MagicSmokeFireworks/magic-smoke-board/README.md

# magic-smoke-board
Electronics schematics, layouts, and part info for the awesome Magic Smoke board.
