MagicSmokeFireworks/magic-smoke-board/cute_octopus_by_jedec.png

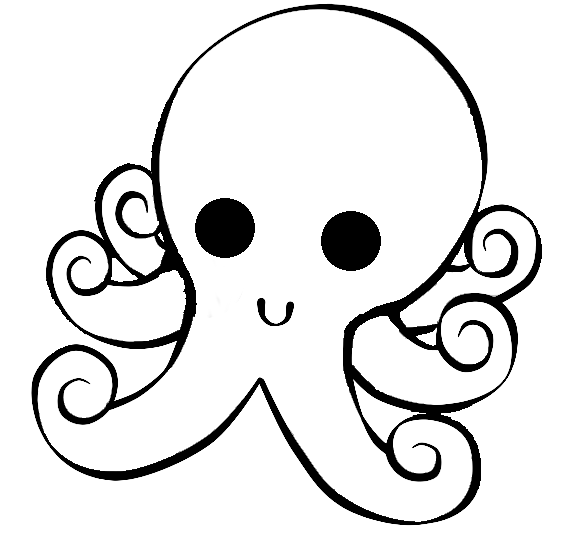
cute_octopus_by_jedec.png
