MagicSmokeFireworks/magic-smoke-board/remote-pallet.kicad_pcb

## KiCad design remote-pallet.kicad_pcb (2019-06-02)

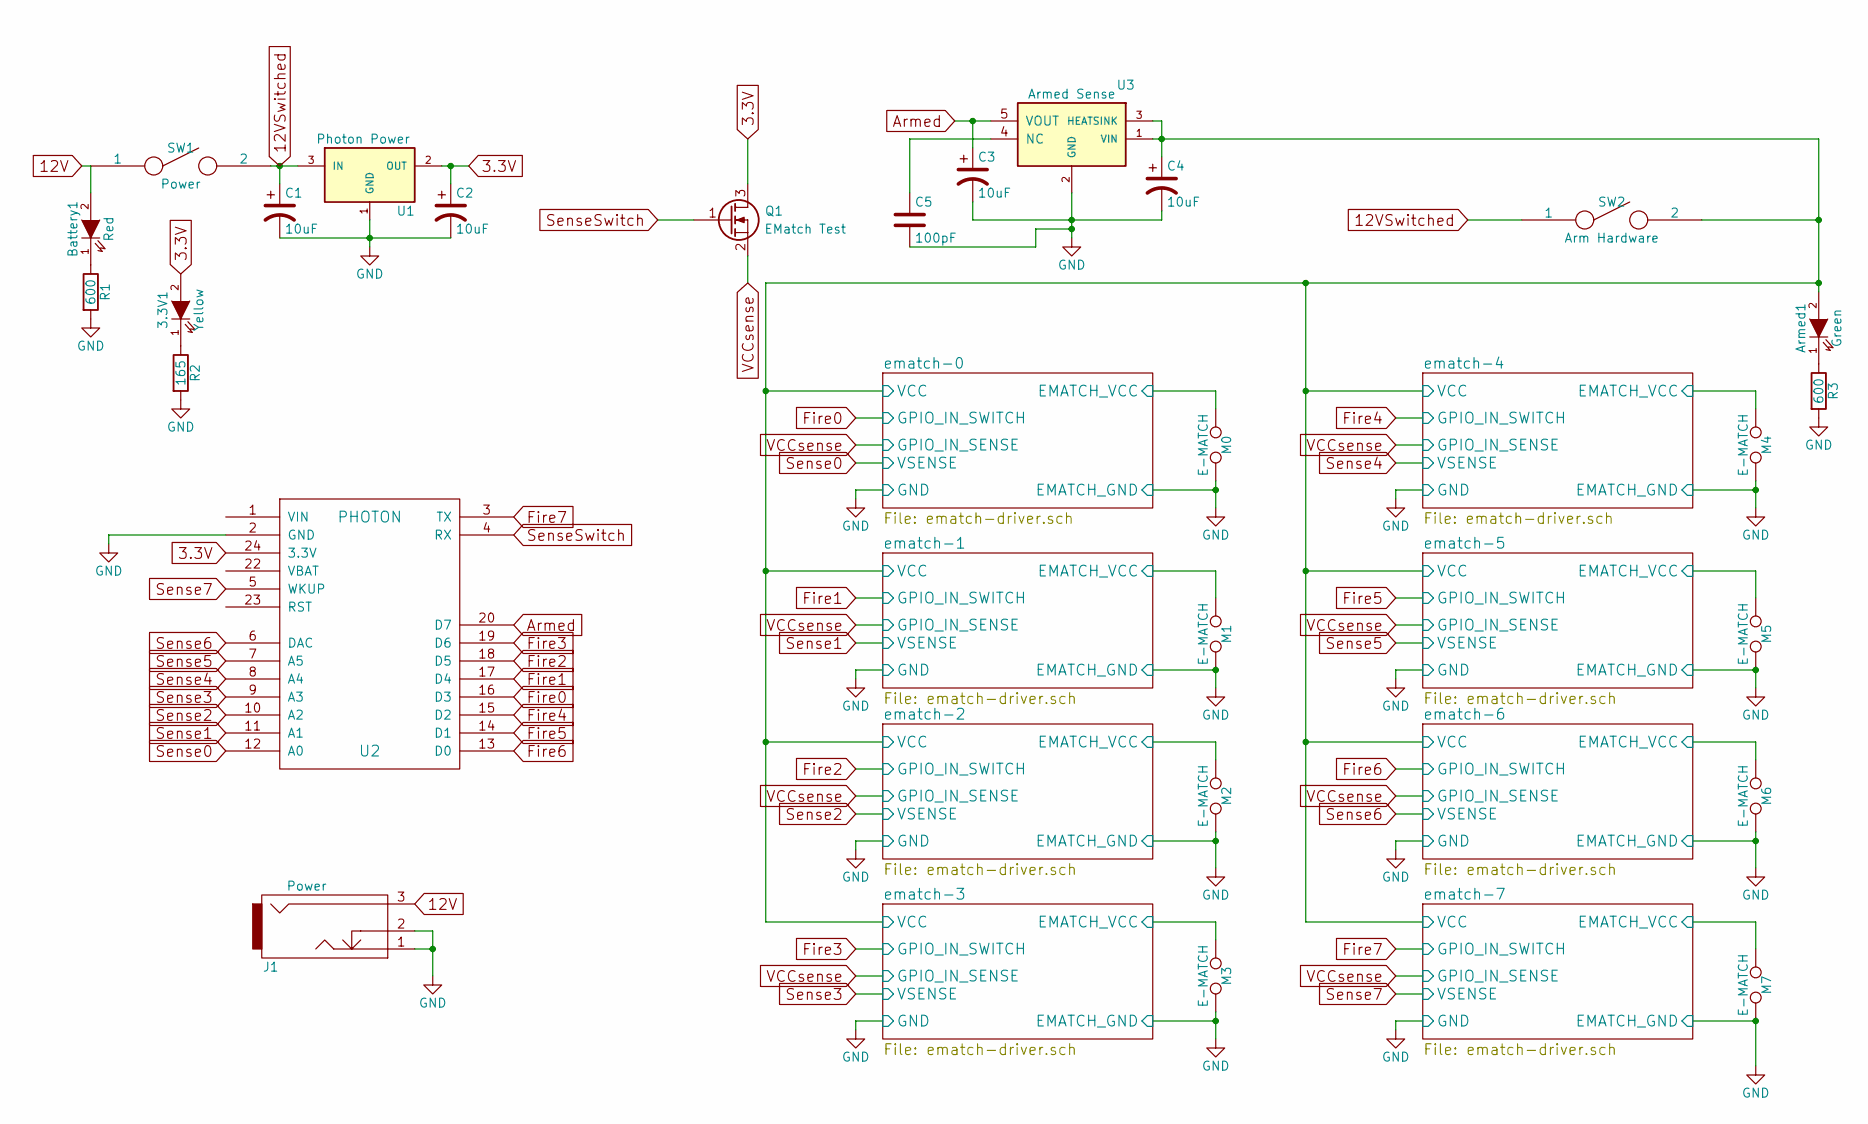
[picture p2: schematic remote-pallet.sch, Fireworks Remote Pallet]

Parts:
3.3V1: Yellow; LED_0603; digikey part no 732-4981-1-ND
Armed1: Green; LED_0603; digikey part no 732-4971-1-ND
Battery1: Red; LED_0603; digikey part no 732-4978-1-ND
C1, C2: 10uF; C_0805_HandSoldering; digikey part no 511-1683-1-ND
C3: 10uF; C_0805_HandSoldering; digikey part no 587-1290-1-ND
C4: 10uF; C_0805_HandSoldering; digikey part no 490-5523-1-ND
C5: 100pF; C_0805_HandSoldering
J1: Power; PJ-082BH-Barrel-Connector; digikey part no CP-082BHCT-ND
M0, M1, M2, M3, M4, M5, M6, M7: E-MATCH; TerminalBlock_Altech_AK300-2_P5.00mm; digikey part no 277-2518-ND
Q1: EMatch Test; SOT-23_Handsoldering; digikey part no SSM3K324RLFCT-ND
R1, R3: 600; R_0603_HandSoldering; digikey part no 311-600HCT-ND
R2: 165; R_0603_HandSoldering; digikey part no 311-165HRCT-ND
SW1: Power; M2011LL1W01; digikey part no 360-3287-ND
SW2: Arm Hardware; M2011LL1W01; digikey part no 360-3287-ND
U1: Photon Power; TO-263-3Lead; digikey part no LM1085ISX-3.3/NOPBCT-ND
U2: PHOTON
U3: Armed Sense; SOT-23-5; digikey part no AP2202K-3.3TRG1DICT-ND

Connections:
3.3V: 3.3V1.2 (A), C2.1, Q1.3 (D), U1.2 (OUT), U2.24 (3.3V)
12V: Battery1.2 (A), J1.3, SW1.1
12VSwitched: C1.1, SW1.2, SW2.1, U1.3 (IN)
/ematch-0/EMATCH_VCC: M0.1; also elsewhere on the board
/ematch-0/VCC: Armed1.2 (A), C4.1, SW2.2, U3.1 (VIN), U3.3 (HEATSINK); also elsewhere on the board
/ematch-1/EMATCH_VCC: M1.1; also elsewhere on the board
/ematch-2/EMATCH_VCC: M2.1; also elsewhere on the board
/ematch-3/EMATCH_VCC: M3.1; also elsewhere on the board
/ematch-4/EMATCH_VCC: M4.1; also elsewhere on the board
/ematch-5/EMATCH_VCC: M5.1; also elsewhere on the board
/ematch-6/EMATCH_VCC: M6.1; also elsewhere on the board
/ematch-7/EMATCH_VCC: M7.1; also elsewhere on the board
Armed: C3.1, U2.20 (D7), U3.5 (VOUT)
Fire0: U2.16 (D3); also elsewhere on the board
Fire1: U2.17 (D4); also elsewhere on the board
Fire2: U2.18 (D5); also elsewhere on the board
Fire3: U2.19 (D6); also elsewhere on the board
Fire4: U2.15 (D2); also elsewhere on the board
Fire5: U2.14 (D1); also elsewhere on the board
Fire6: U2.13 (D0); also elsewhere on the board
Fire7: U2.3 (TX); also elsewhere on the board
GND: C1.2, C2.2, C3.2, C4.2, C5.2, J1.1, J1.2, M0.2, M1.2, M2.2, M3.2, M4.2, M5.2, M6.2, M7.2, R1.2, R2.2, R3.2, U1.1 (GND), U2.2 (GND), U3.2 (GND); also elsewhere on the board
unnamed: 3.3V1.1 (K), R2.1
unnamed: Armed1.1 (K), R3.1
unnamed: Battery1.1 (K), R1.1
unnamed: C5.1, U3.4 (NC)
Sense0: U2.12 (A0); also elsewhere on the board
Sense1: U2.11 (A1); also elsewhere on the board
Sense2: U2.10 (A2); also elsewhere on the board
Sense3: U2.9 (A3); also elsewhere on the board
Sense4: U2.8 (A4); also elsewhere on the board
Sense5: U2.7 (A5); also elsewhere on the board
Sense6: U2.6 (DAC); also elsewhere on the board
Sense7: U2.5 (WKUP); also elsewhere on the board
SenseSwitch: Q1.1 (G), U2.4 (RX)
VCCsense: Q1.2 (S); also elsewhere on the board

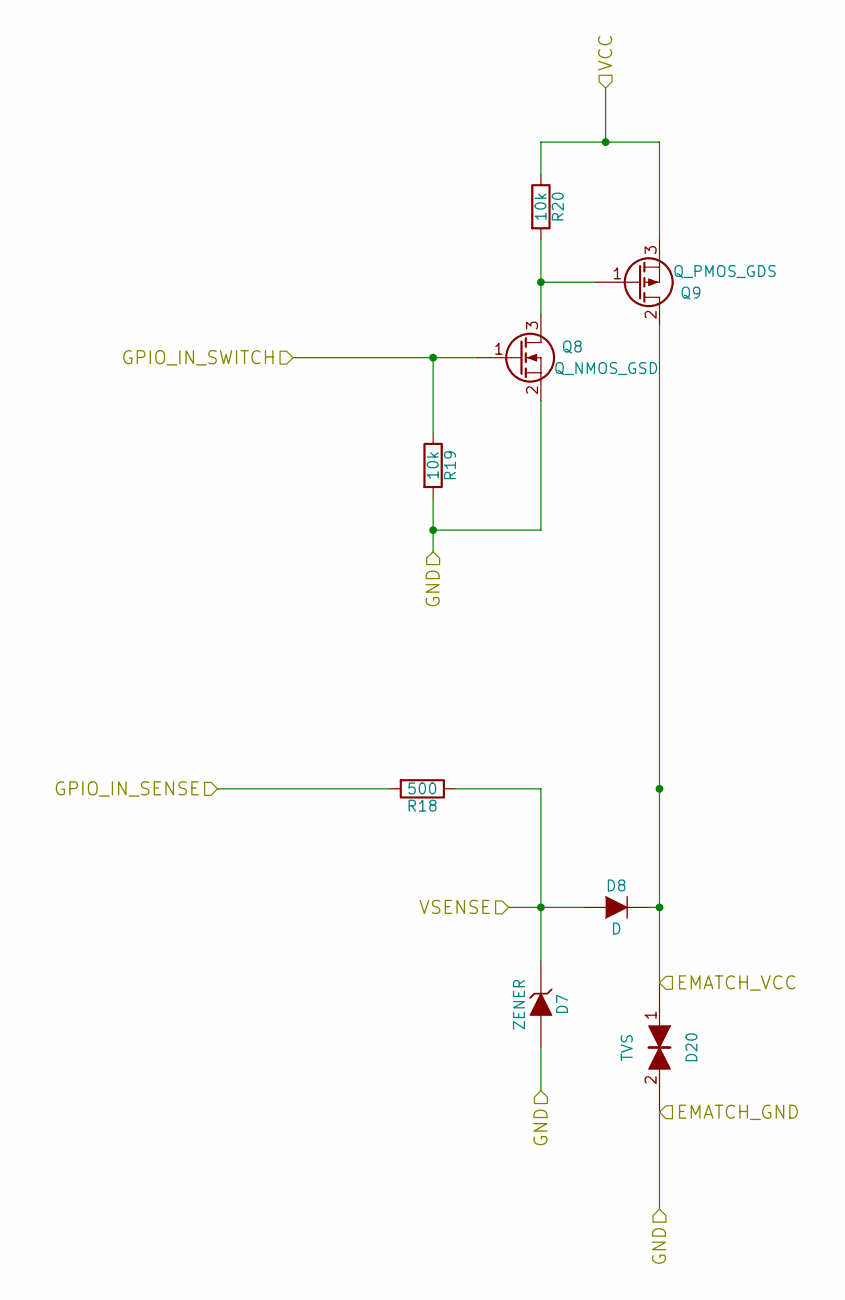
[picture p3: schematic ematch-driver.sch]

Parts:
D1: ZENER; SOD-123; digikey part no CD0603-Z3V3CT-ND
D2: D; SOD-123; digikey part no 641-1282-2-ND
D17: TVS; D_SMA_Handsoldering; digikey part no SMAJ30CALFTR-ND
Q2: Q_NMOS_GSD; SOT-23_Handsoldering; digikey part no SSM3K324RLFCT-ND
Q3: Q_PMOS_GDS; TO-252-2Lead; digikey part no NTD2955T4GOSCT-ND
R9: 500; R_0603_HandSoldering; digikey part no 311-499HRCT-ND
R10, R11: 10k; R_0603_HandSoldering; digikey part no 311-10KGRCT-ND

Connections:
/ematch-0/EMATCH_VCC: D2.1 (K), D17.1, Q3.2 (D); also elsewhere on the board
/ematch-0/VCC: Q3.3 (S), R11.1; also elsewhere on the board
Fire0: Q2.1 (G), R10.1; also elsewhere on the board
GND: D1.2 (A), D17.2, Q2.2 (S), R10.2; also elsewhere on the board
unnamed: Q2.3 (D), Q3.1 (G), R11.2
Sense0: D1.1 (K), D2.2 (A), R9.1; also elsewhere on the board
VCCsense: R9.2; also elsewhere on the board

Parts of its further copies:
D3, D5, D7, D9, D11, D13, D15: ZENER; SOD-123; digikey part no CD0603-Z3V3CT-ND
D4, D6, D8, D10, D12, D14, D16: D; SOD-123; digikey part no 641-1282-2-ND
D18, D19, D20, D21, D22, D23, D24: TVS; D_SMA_Handsoldering; digikey part no SMAJ30CALFTR-ND
Q4, Q6, Q8, Q10, Q12, Q14, Q16: Q_NMOS_GSD; SOT-23_Handsoldering; digikey part no SSM3K324RLFCT-ND
Q5, Q7, Q9, Q11, Q13, Q15, Q17: Q_PMOS_GDS; TO-252-2Lead; digikey part no NTD2955T4GOSCT-ND
R12, R15, R18, R21, R24, R27, R30: 500; R_0603_HandSoldering; digikey part no 311-499HRCT-ND
R13, R14, R16, R17, R19, R20, R22, R23, R25, R26, R28, R29, R31, R32: 10k; R_0603_HandSoldering; digikey part no 311-10KGRCT-ND

Connections of its further copies:
/ematch-0/VCC: Q5.3 (S), Q7.3 (S), Q9.3 (S), Q11.3 (S), Q13.3 (S), Q15.3 (S), Q17.3 (S), R14.1, R17.1, R20.1, R23.1, R26.1, R29.1, R32.1; also elsewhere on the board
/ematch-1/EMATCH_VCC: D4.1 (K), D18.1, Q5.2 (D); also elsewhere on the board
/ematch-2/EMATCH_VCC: D6.1 (K), D19.1, Q7.2 (D); also elsewhere on the board
/ematch-3/EMATCH_VCC: D8.1 (K), D20.1, Q9.2 (D); also elsewhere on the board
/ematch-4/EMATCH_VCC: D10.1 (K), D21.1, Q11.2 (D); also elsewhere on the board
/ematch-5/EMATCH_VCC: D12.1 (K), D22.1, Q13.2 (D); also elsewhere on the board
/ematch-6/EMATCH_VCC: D14.1 (K), D23.1, Q15.2 (D); also elsewhere on the board
/ematch-7/EMATCH_VCC: D16.1 (K), D24.1, Q17.2 (D); also elsewhere on the board
Fire1: Q4.1 (G), R13.1; also elsewhere on the board
Fire2: Q6.1 (G), R16.1; also elsewhere on the board
Fire3: Q8.1 (G), R19.1; also elsewhere on the board
Fire4: Q10.1 (G), R22.1; also elsewhere on the board
Fire5: Q12.1 (G), R25.1; also elsewhere on the board
Fire6: Q14.1 (G), R28.1; also elsewhere on the board
Fire7: Q16.1 (G), R31.1; also elsewhere on the board
GND: D3.2 (A), D5.2 (A), D7.2 (A), D9.2 (A), D11.2 (A), D13.2 (A), D15.2 (A), D18.2, D19.2, D20.2, D21.2, D22.2, D23.2, D24.2, Q4.2 (S), Q6.2 (S), Q8.2 (S), Q10.2 (S), Q12.2 (S), Q14.2 (S), Q16.2 (S), R13.2, R16.2, R19.2, R22.2, R25.2, R28.2, R31.2; also elsewhere on the board
unnamed: Q4.3 (D), Q5.1 (G), R14.2
unnamed: Q6.3 (D), Q7.1 (G), R17.2
unnamed: Q8.3 (D), Q9.1 (G), R20.2
unnamed: Q10.3 (D), Q11.1 (G), R23.2
unnamed: Q12.3 (D), Q13.1 (G), R26.2
unnamed: Q14.3 (D), Q15.1 (G), R29.2
unnamed: Q16.3 (D), Q17.1 (G), R32.2
Sense1: D3.1 (K), D4.2 (A), R12.1; also elsewhere on the board
Sense2: D5.1 (K), D6.2 (A), R15.1; also elsewhere on the board
Sense3: D7.1 (K), D8.2 (A), R18.1; also elsewhere on the board
Sense4: D9.1 (K), D10.2 (A), R21.1; also elsewhere on the board
Sense5: D11.1 (K), D12.2 (A), R24.1; also elsewhere on the board
Sense6: D13.1 (K), D14.2 (A), R27.1; also elsewhere on the board
Sense7: D15.1 (K), D16.2 (A), R30.1; also elsewhere on the board
VCCsense: R12.2, R15.2, R18.2, R21.2, R24.2, R27.2, R30.2; also elsewhere on the board

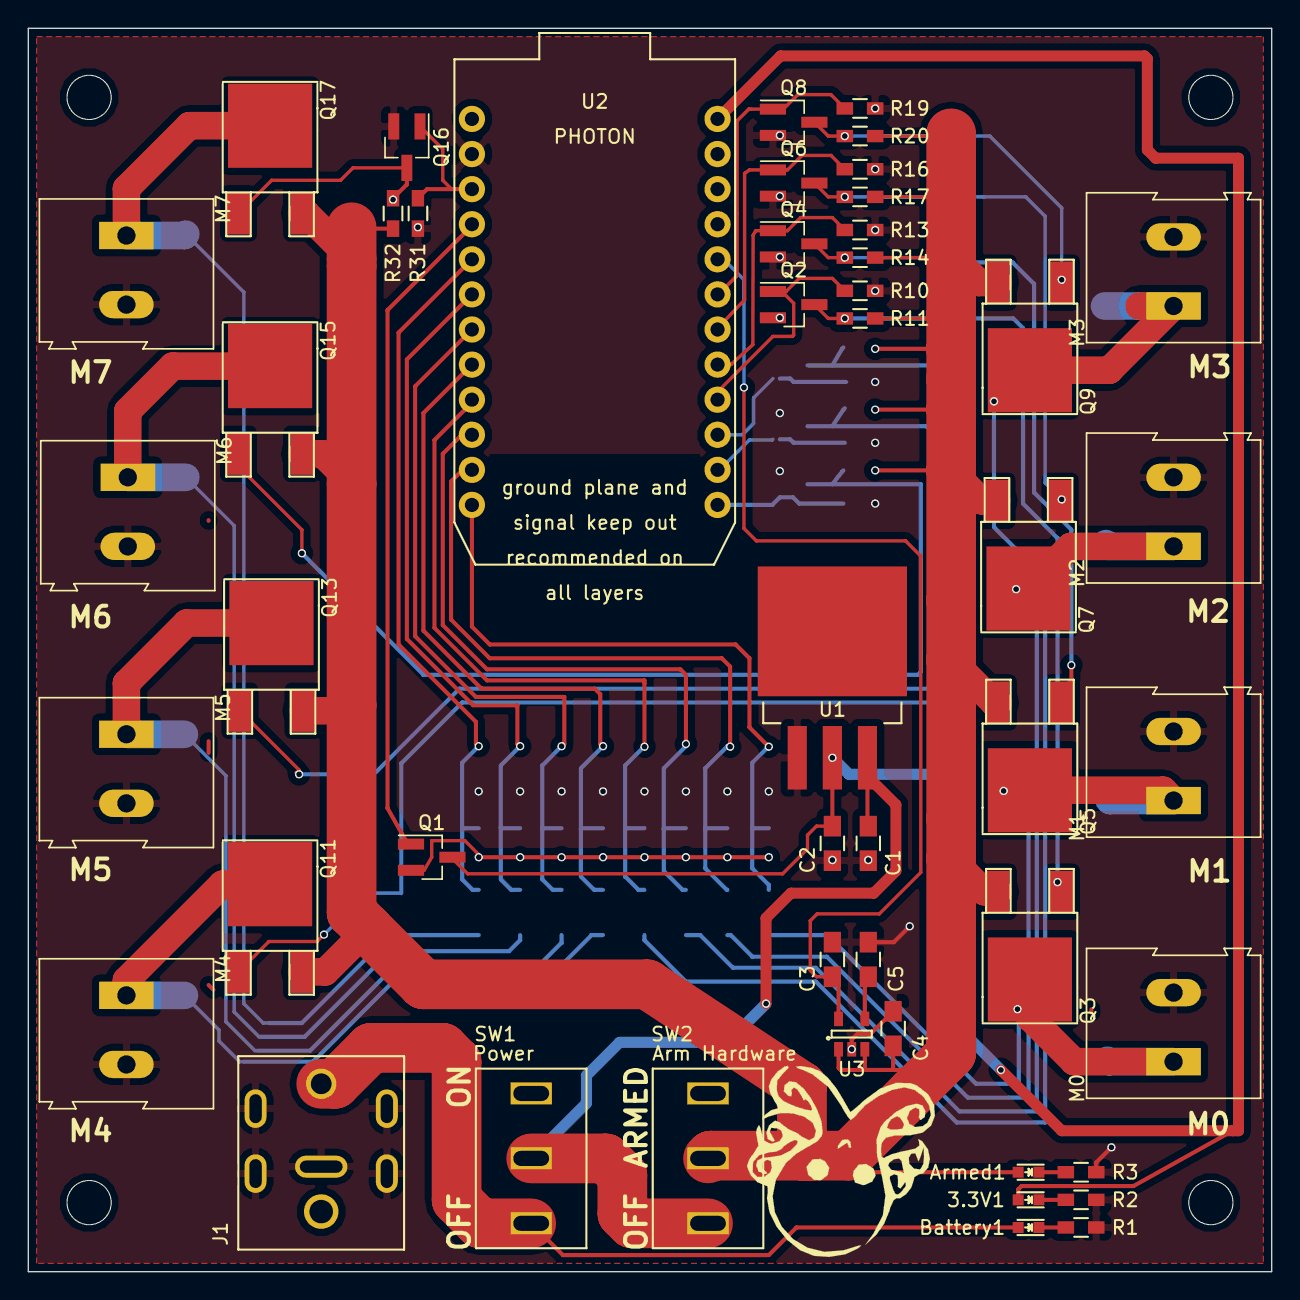
[picture p4: board remote-pallet.kicad_pcb from above]

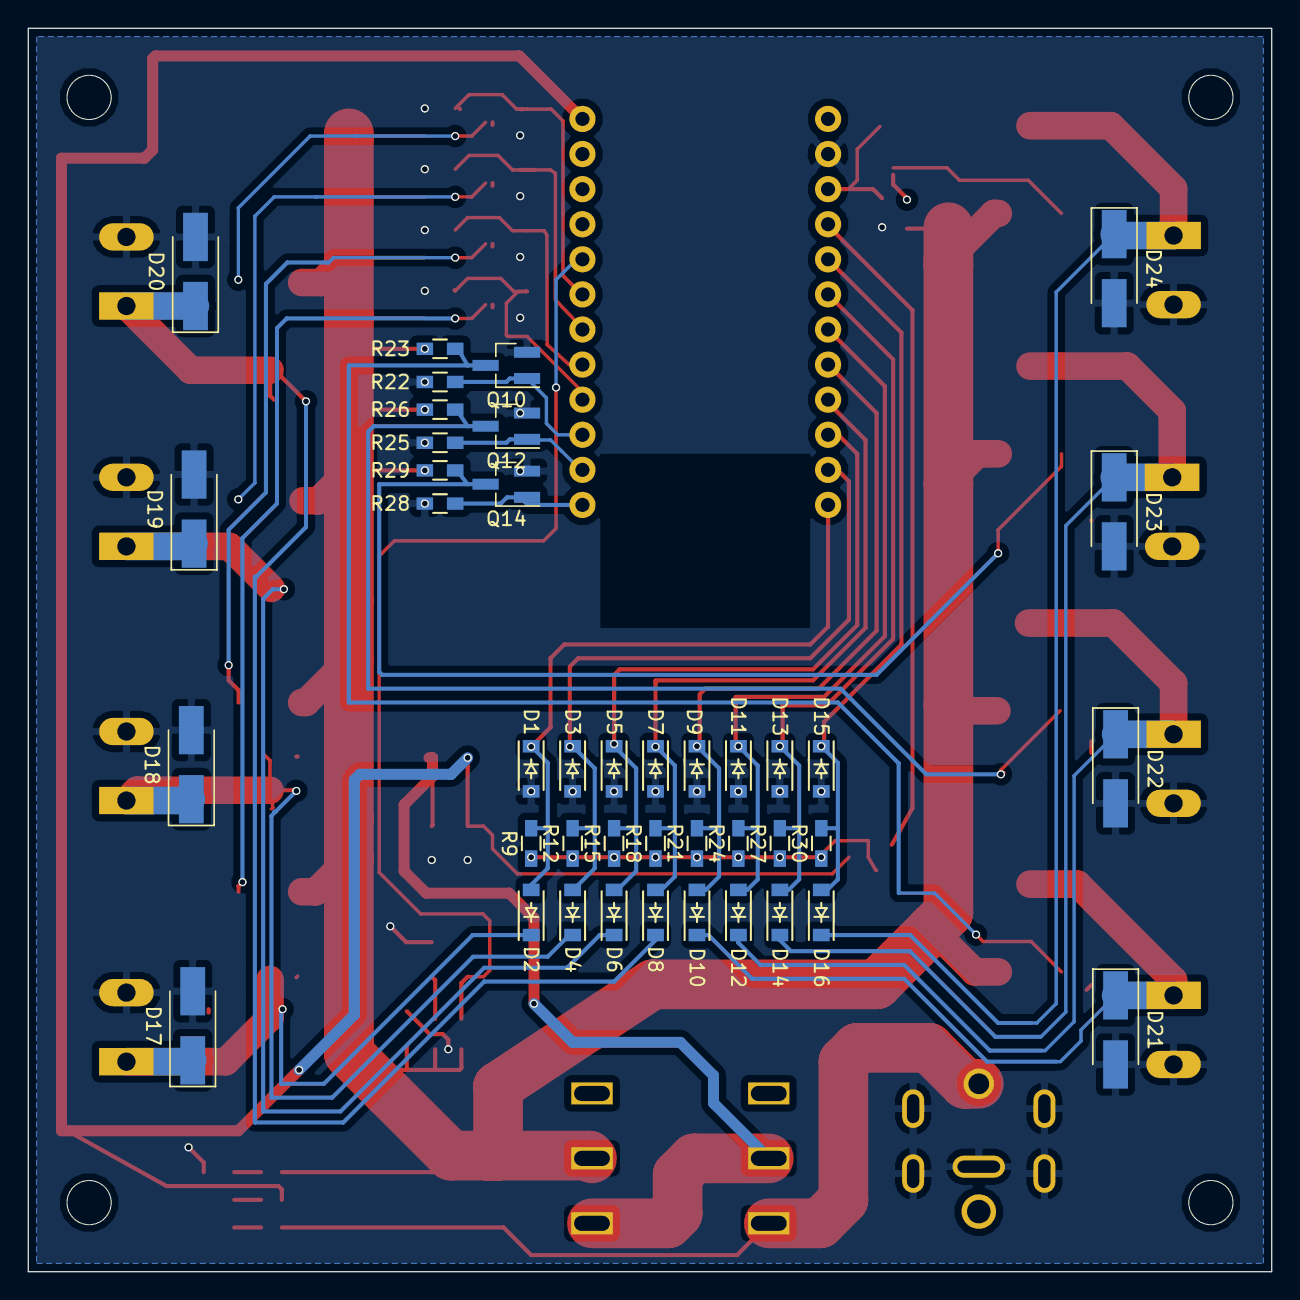
[picture p5: board remote-pallet.kicad_pcb from below]

Board: 2 copper layers, 90.0 x 90.0 mm, 90 parts (41 on the bottom side), 44 nets.
