MagicSmokeFireworks/magic-smoke-board/(threads)

Thread 4 (2016-09-14):

diagnostic led

DaedalusSC, 2016-09-14:
Add LEDs to show which channel is firing for 'dry run' kind of tests. Could port to old boards using stackable header design.

viomonger, 2017-03-08:
decided not to pursue diagnostic LEDs

DaedalusSC, 2017-03-08:
No good way to put on the board, and not sure how much benefit they will be when live on the show. Should make a test bed with LED and stuff for quick board verification.

Closed 2017-03-08.

Thread 5 (2017-02-25):

Discuss acquisition of hardware peripherals

viomonger, 2017-02-25:
Our first batch had external antennas and batteries, and some had enclosures. Some kind of batteries would seem required. The external antennas did demonstrate improvement in signal strength, and Greg's stunts suggest we need every dB we can get. And enclosures of some kind would be nice, but I'm not sure what angle to pursue on that front. We should discuss...

DaedalusSC, 2017-03-08:
Some of the issues were caused by the antennas being flat on the ground (like Gregs)

DaedalusSC, 2017-03-08:
Test: With and without antenna?
Test: With antenna flat vs up.
Figure out what the signal strength number the Photon gives us means.

DaedalusSC, 2017-03-08:
Enclosure desires:

Good place to mount antenna.
Integrate battery.
Easy access to wire terminals.
Rain protection (fireworks and real rain)
Actuate switches.
See some of board.

????

viomonger, 2019-07-19:
From testing, antenna matters and elevation matters a lot more than orientation.
Defined rough bounds in the firmware/cloud on how the signal strength (RSSI) number corresponds to signal reliability.

Closed 2019-07-19.

Thread 6 (2019-07-19):

Thoughts for a possible next-generation board design

viomonger, 2019-07-19:
- [ ] spec hardware on each channel to handle firing at least 3 e-matches (something that was prevalent in the 2019 show)
- [ ] spec hardware to handle up to a 10 second fire duration (something desirable for things like rocket motors?)
- [ ] instead of 1 fet driving the load, consider two fets (one high, one low) to provide an additional safety factor preventing unintended activation
- [ ] Investigate what the right number of channels per board is. Seems like 8 is limiting, could easily go to 12? or more?
- [ ] Think about onboard non-volatile memory options that provide avenues for more after-show diagnosis of what happened on each board
- [ ] Reconsider the communication aspect. We seem to be bumping up against the limits of standard WIFI (at least with consumer network hardware). Do the available mesh systems provide a better solution (and integrate into our existing system)? If we can put an upper-bound on the number of individual boards required (and possibly increase the capacity of the boards with 12 or more channels) what would a wired (ethernet) communication system look like - would it be a complete mess?
