MagicSmokeFireworks/magic-smoke-board/(commit log)

2016-06-15 adding hardware
    [ematch-driver.sch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]
2017-02-12 fucking mac windows manager is a pile of shit
    [ematch-driver.sch]
2019-06-02 Updates from 2018 rev
    [ematch-driver.sch, remote-pallet.kicad_pcb, remote-pallet.sch]
